blinkyparts/heart_NE555_dual-light_THT/(commit log)

2025-01-29 added gitignore for kicad specific files
2025-01-29 inital commit for heart v1.3 - non working edition
    [Heart_NE555_THT-B_Cu.gbr, Heart_NE555_THT-B_Mask.gbr, Heart_NE555_THT-B_Paste.gbr, Heart_NE555_THT-B_Silkscreen.gbr, Heart_NE555_THT-Edge_Cuts.gbr, Heart_NE555_THT-F_Cu.gbr, Heart_NE555_THT-F_Mask.gbr, Heart_NE555_THT-F_Paste.gbr]
2025-01-29 changed shottky to normal 1N4007. added capacitor and changed sw1 to correct footprint
    [Heart_NE555_THT.kicad_sch]
2025-01-29 placed new parts - not yet ready
    [Heart_NE555_THT.kicad_pcb]
2025-01-30 Routing finished
    [Heart_NE555_THT.kicad_pcb, Heart_NE555_THT.kicad_sch]
2025-02-05 Issue with not connected Pin fixed
    [Heart_NE555_THT.kicad_pcb]
2025-03-04 smaller changes on Silkscreen
    [Heart_NE555_THT.kicad_pcb]
2025-04-07 updated to kicad 9
    [Heart_NE555_THT-B_Cu.gbr, Heart_NE555_THT-B_Mask.gbr, Heart_NE555_THT-B_Paste.gbr, Heart_NE555_THT-B_Silkscreen.gbr, Heart_NE555_THT-Edge_Cuts.gbr, Heart_NE555_THT-F_Cu.gbr, Heart_NE555_THT-F_Mask.gbr, Heart_NE555_THT-F_Paste.gbr]
